E-gora-code/ArduinoCar/Render/angled.png

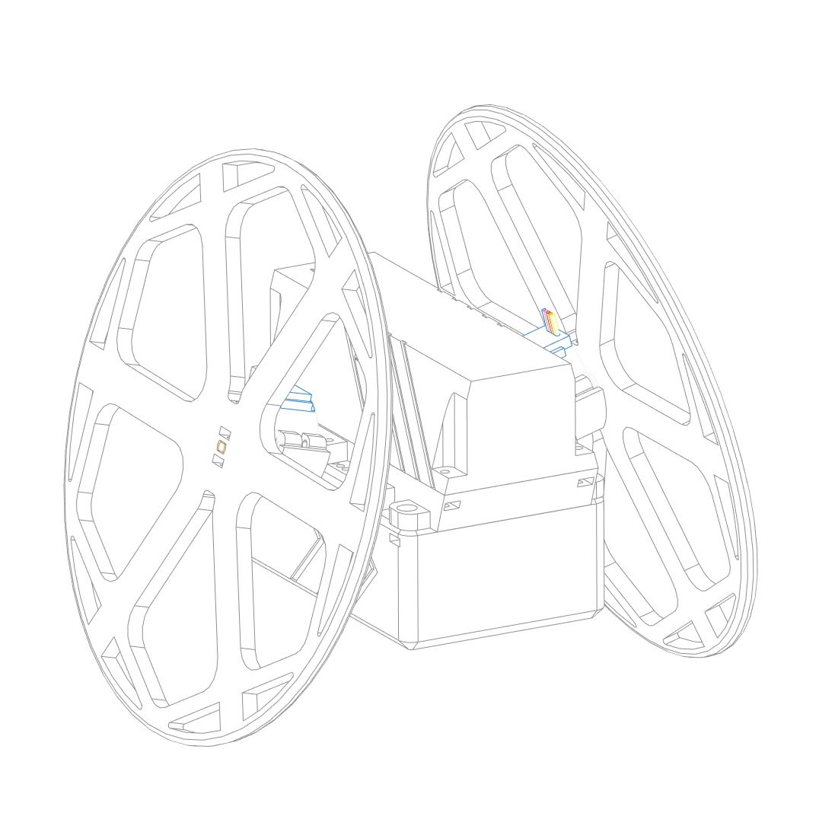
Render/angled.png
