E-gora-code/ArduinoCar/Render/cut.png

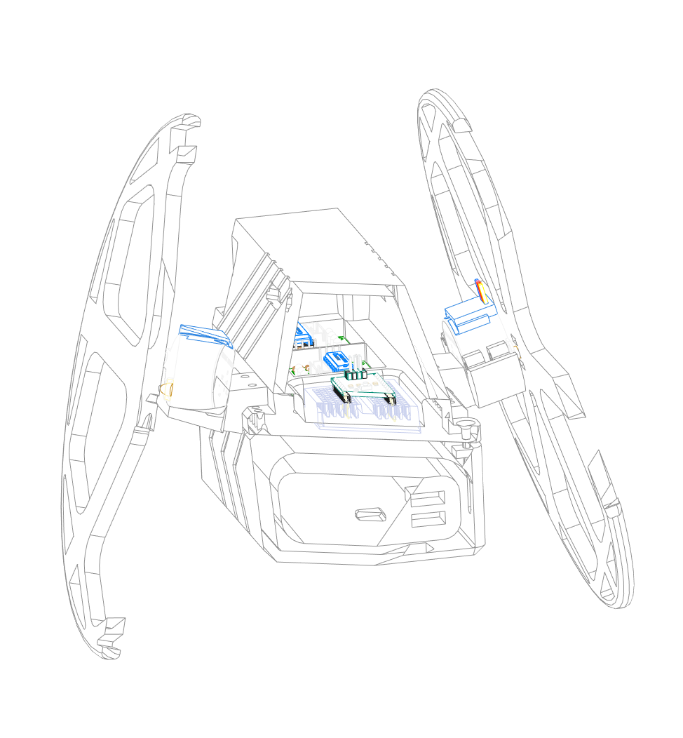
Render/cut.png
