E-gora-code/ArduinoCar/Render/rear.png

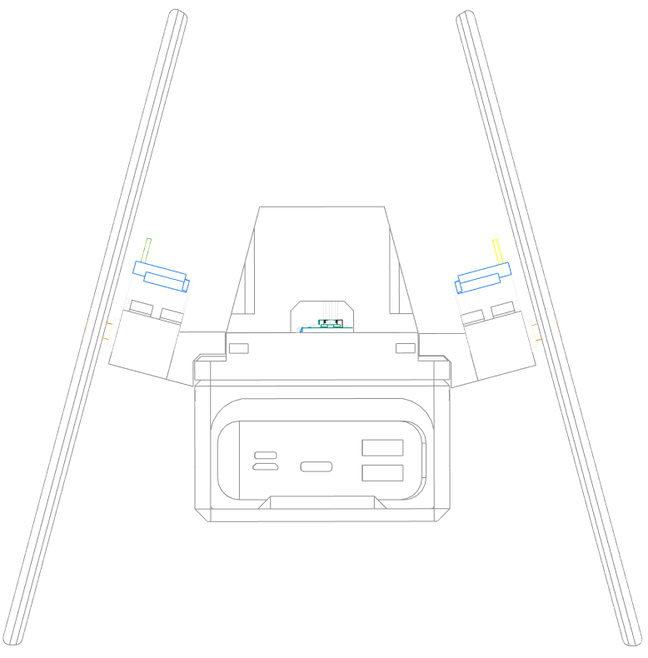
Render/rear.png
