E-gora-code/ArduinoCar/Render/side.png

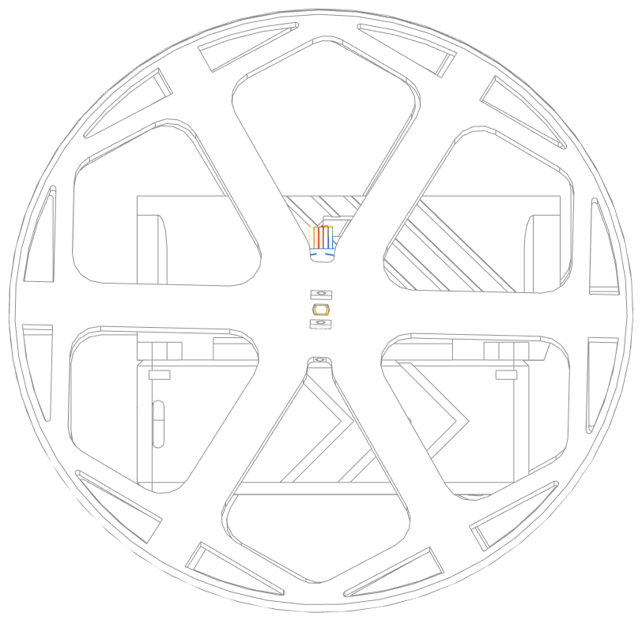
Render/side.png
