E-gora-code/ArduinoCar/Render/top.png

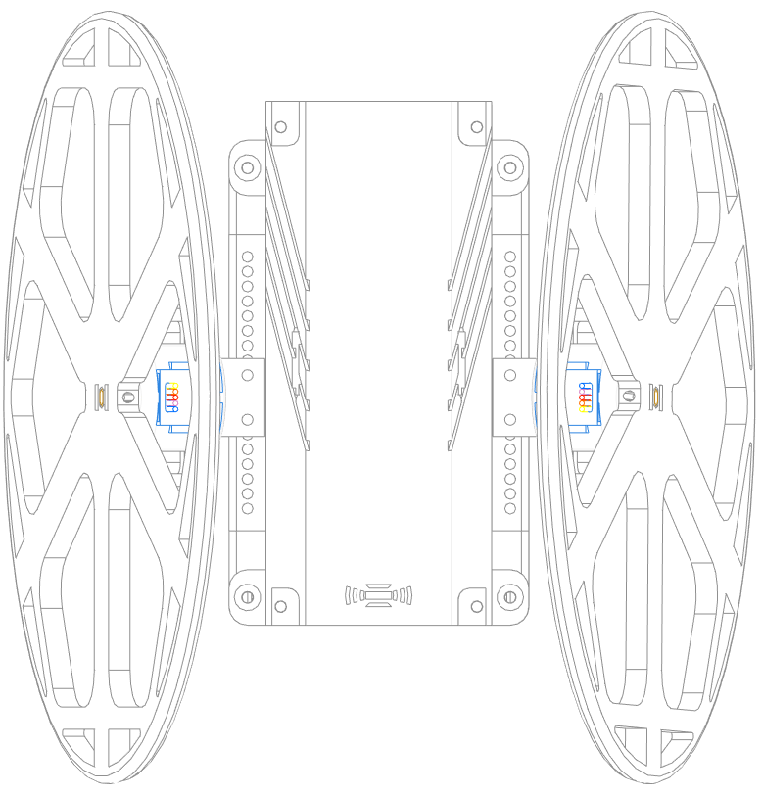
Render/top.png
