E-gora-code/ArduinoCar/Docs/BOM-ru.xlsx

Материалы | Стоимость за ед ₽ | количество | Стоимость ₽ | Ссылка
Плата Arduino nano или аналог | 152/шт | 1шт | 152 | https://aliexpress.ru/item/1005006773519913.html?sku_id=12000038256018928
Беспаечная макетная плата 170 точек | 76/шт | 1шт | 76 | https://aliexpress.ru/item/1005008058126014.html?sku_id=12000043483279455
Шаговый двигатель 28BYJ-48 | 64/шт | 2шт | 128 | https://aliexpress.ru/item/32906617266.html?sku_id=12000027293392610
Драйвер для шагового двигателя 28BYJ-48 | 11/шт | 2шт | 22 | https://aliexpress.ru/item/32906617266.html?sku_id=12000027293392612
Провода перемычки для макетных плат | 249/120шт | 23шт | 48 | https://aliexpress.ru/item/1005004516091631.html?filters=&sku_id=12000042862896611
Ик приёмник TZT TL1838 VS1838B | 61/10шт | 1шт | 7 | https://aliexpress.ru/item/1005009864221240.html?sku_id=12000052582227426
Болт М3 16мм потайной | 54/10шт | 36шт | 195 | https://aliexpress.ru/item/1005003271053340.html?sku_id=12000024952407799
Гайка М3 квадратная(5,5*5,5*2) или обычная | 94/40шт | 36шт | 85 | https://aliexpress.ru/item/1005006994579607.html?sku_id=12000038983548910
Пластик для 3Д печати PLA | 1209/кг | 0,5кг | 605 | https://aliexpress.ru/item/1005007445213360.html?sku_id=12000051671093104
 |  |  | 1318
