E-gora-code/ArduinoCar/esp-wroom-32d-dev-board-v1.step

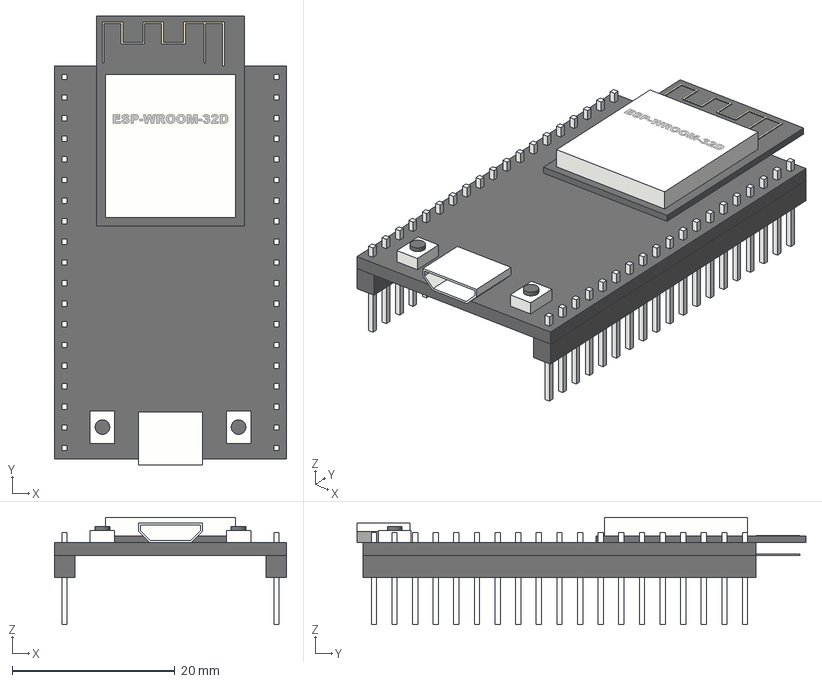
[picture p20: CAD file, 2025-10-03]
esp-wroom-32d-dev-board-v1.step
28.5 x 55.1 x 13.1 mm
