E-gora-code/ArduinoCar/Print/Motor_wheel_adapter.stp

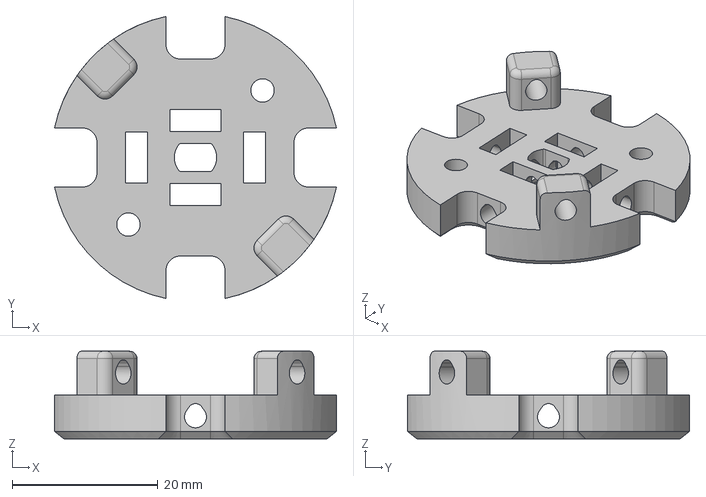
[picture p21: CAD file, 2025-12-12]
Print/Motor_wheel_adapter.stp
38.7 x 38.7 x 12.0 mm
