E-gora-code/ArduinoCar/Print/Wheel.stp

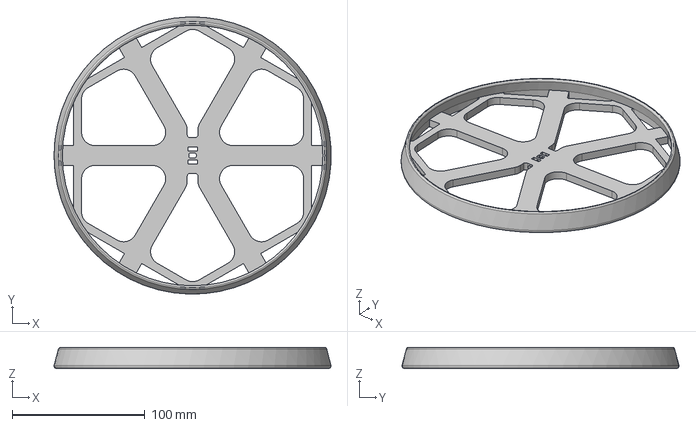
[picture p22: CAD file, 2025-10-11]
Print/Wheel.stp
208.6 x 208.7 x 16.0 mm
