E-gora-code/ArduinoCar/Print/TopShell.stp

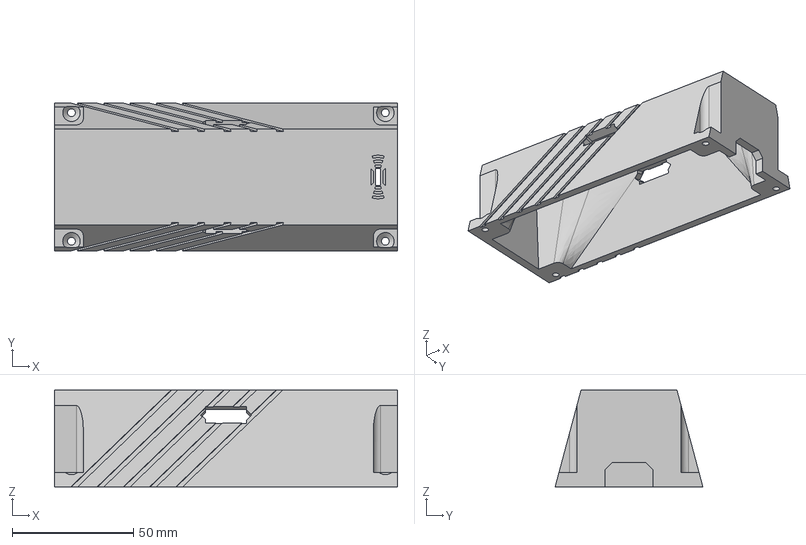
[picture p23: CAD file, 2025-10-11]
Print/TopShell.stp
141.5 x 61.0 x 40.0 mm
