E-gora-code/ArduinoCar/Print/PowerBay.stp

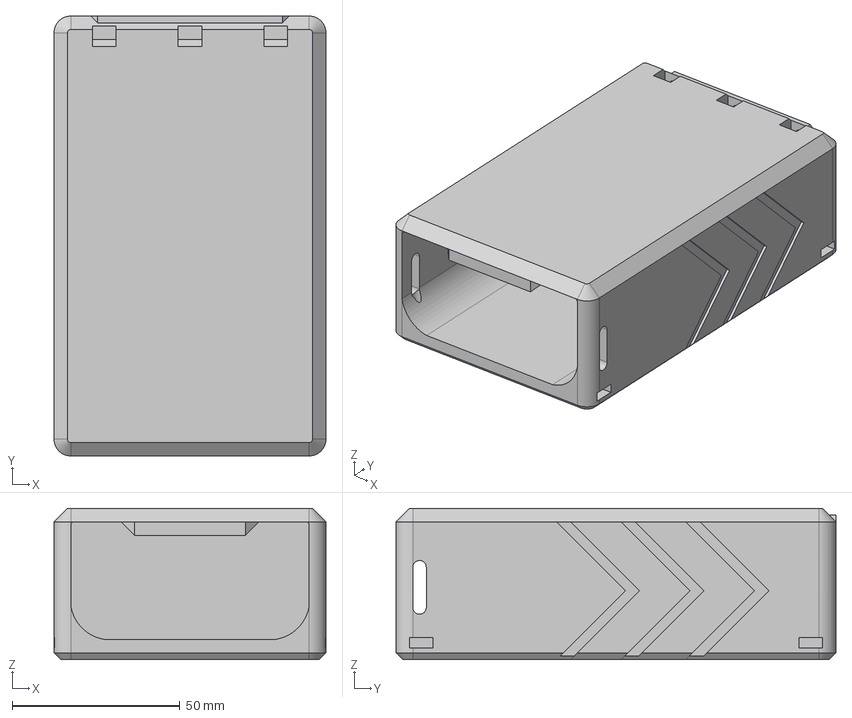
[picture p24: CAD file, 2025-10-07]
Print/PowerBay.stp
81.0 x 131.0 x 45.0 mm
