E-gora-code/ArduinoCar/Print/CurcitBody.stp

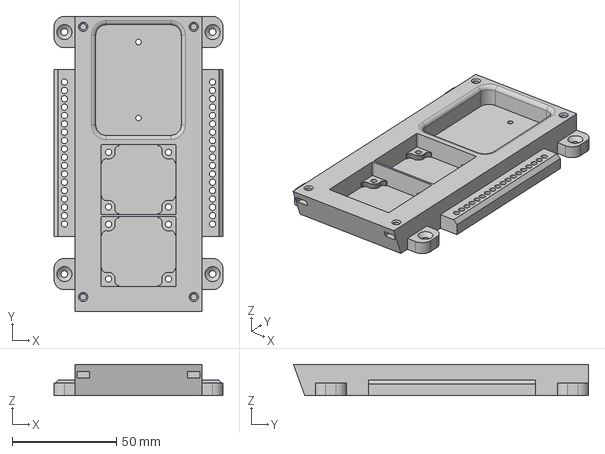
[picture p25: CAD file, 2025-10-04]
Print/CurcitBody.stp
81.0 x 141.5 x 15.0 mm
