E-gora-code/ArduinoCar/Print/MotorMount.stp

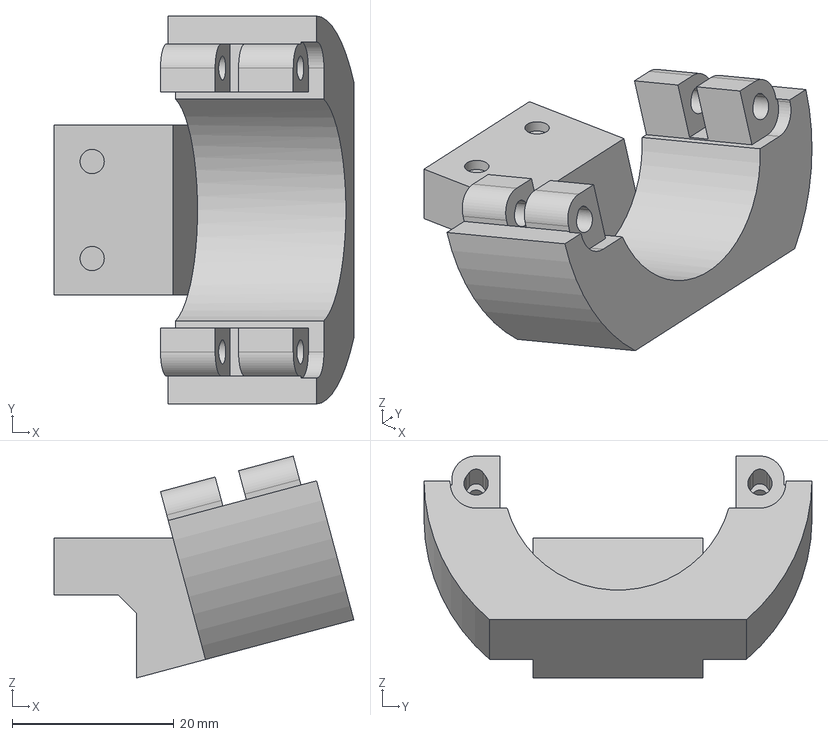
[picture p26: CAD file, 2025-10-03]
Print/MotorMount.stp
37.1 x 48.0 x 27.5 mm
