E-gora-code/ArduinoCar/(list of files, cad)

Other CAD files:
Print/Motor_wheel_adapter.stl
