E-gora-code/ArduinoCar/(commit log)

2025-10-01 Create Rohs Step Motor 28BYJ-48 5V DC.m3d
    Added motor
2025-10-01 Modeled Power Bamk
2025-10-01 Its going
    [Test.stp]
2025-10-02 Motor mounts!
2025-10-03 Power bay yay!
2025-10-03 started top shell
    [Wheel.stp]
2025-10-03 Looking forward for esp
    [esp-wroom-32d-dev-board-v1.step]
2025-10-05 Fixed holes
2025-10-07 Mount holes!
2025-10-10 Added second motor
2025-10-10 fixed cad
2025-10-10 some active coding
    [TopShell.stp]
2025-10-10 Added power off
2025-10-11 better weeels
    [Wheel.stp]
2025-11-23 Wheel hub
2025-12-05 slised it
    [Motor_wheel_adapter.stl, Motor_wheel_adapter.stp]
2025-12-06 Added BOM
    [BOM-ru.xlsx]
2025-12-06 Fineshed BOM
    [BOM-ru.xlsx]
2025-12-06 and again
    [BOM-ru.xlsx]
2025-12-09 added fixedstepping feature (not tested)
    [IR-controll.ino]
2025-12-09 esp pico in asembly
2025-12-12 quick wheels prototype
